kim-xps12/bsl-plotter/catkin_ws/src/bsl_plotter_description/meshes/base_link.stl

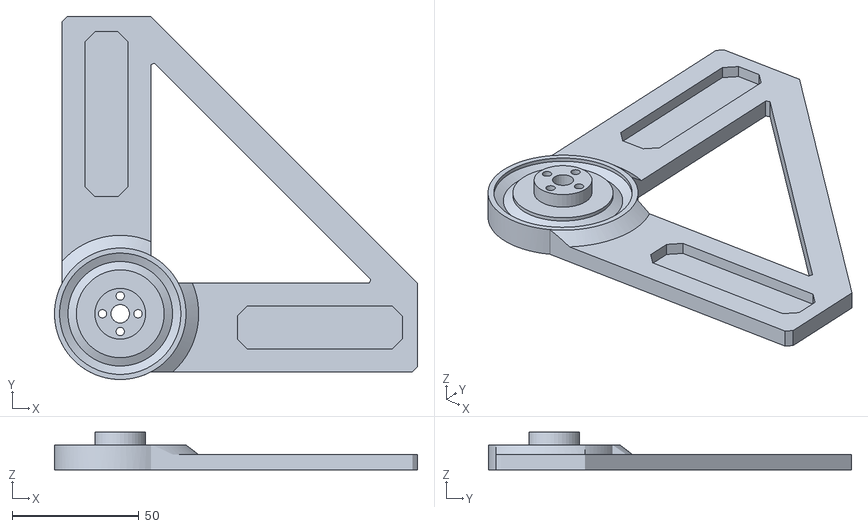
[picture p2: CAD file, 2023-05-23]
catkin_ws/src/bsl_plotter_description/meshes/base_link.stl
143.0 x 143.0 x 14.8
