kim-xps12/bsl-plotter/stl/rod_forearm v4.stl

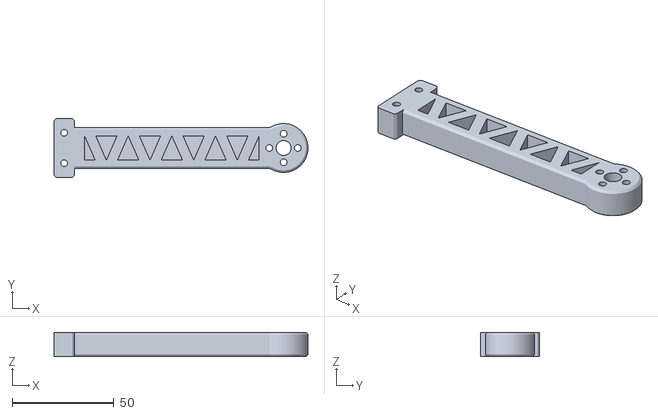
[picture p3: CAD file, 2023-05-24]
stl/rod_forearm v4.stl
124.8 x 29.0 x 12.0
