kim-xps12/bsl-plotter/catkin_ws/src/bsl_plotter_description/meshes/link_hand_v9_1.stl

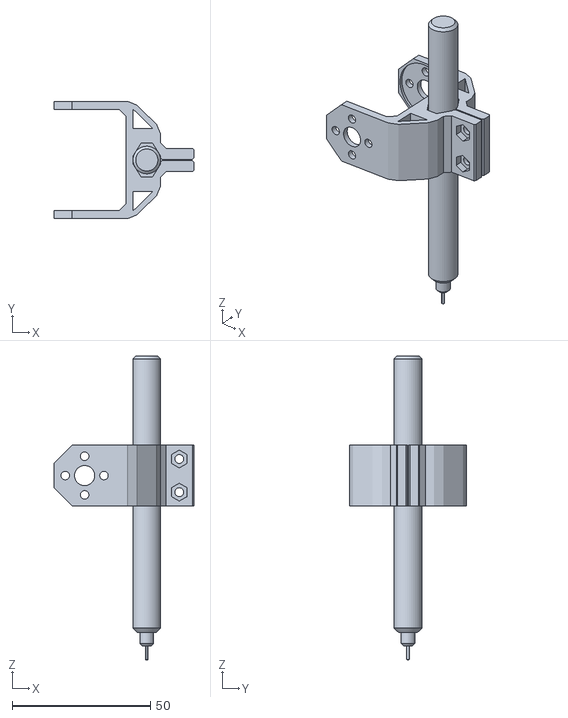
[picture p4: CAD file, 2023-05-23]
catkin_ws/src/bsl_plotter_description/meshes/link_hand_v9_1.stl
50.5 x 42.5 x 110.0
