kim-xps12/bsl-plotter/stl/mount_servo_arm_1 v24.stl

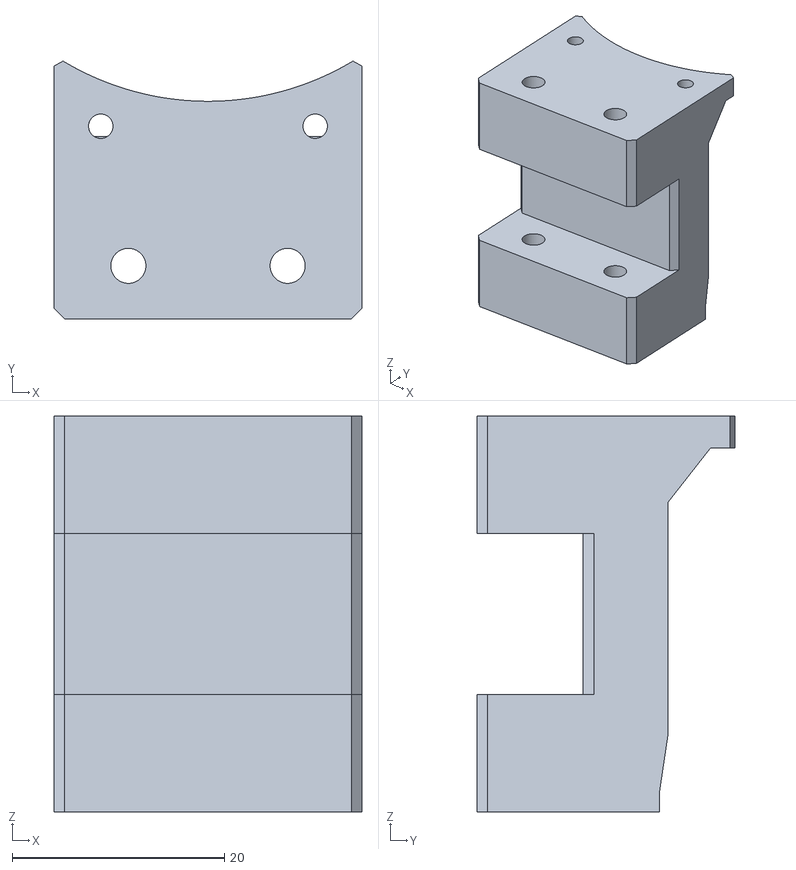
[picture p5: CAD file, 2023-05-24]
stl/mount_servo_arm_1 v24.stl
29.0 x 24.3 x 37.3
