kim-xps12/bsl-plotter/catkin_ws/src/bsl_plotter_description/meshes/link_upper_arm_v7_1.stl

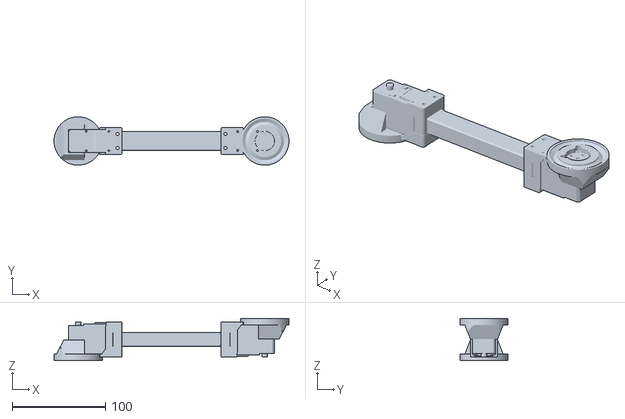
[picture p6: CAD file, 2023-05-23]
catkin_ws/src/bsl_plotter_description/meshes/link_upper_arm_v7_1.stl
251.8 x 51.8 x 45.2
