kim-xps12/bsl-plotter/catkin_ws/src/bsl_plotter_description/meshes/link_fore_arm_v4_1.stl

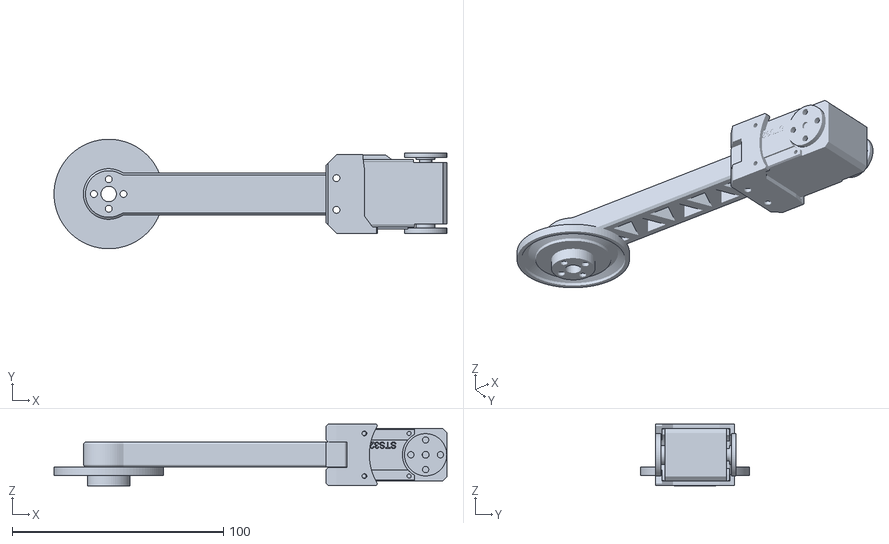
[picture p7: CAD file, 2023-05-23]
catkin_ws/src/bsl_plotter_description/meshes/link_fore_arm_v4_1.stl
186.0 x 51.8 x 29.2
