kim-xps12/bsl-plotter/stl/thrust_bearing_a v7.stl

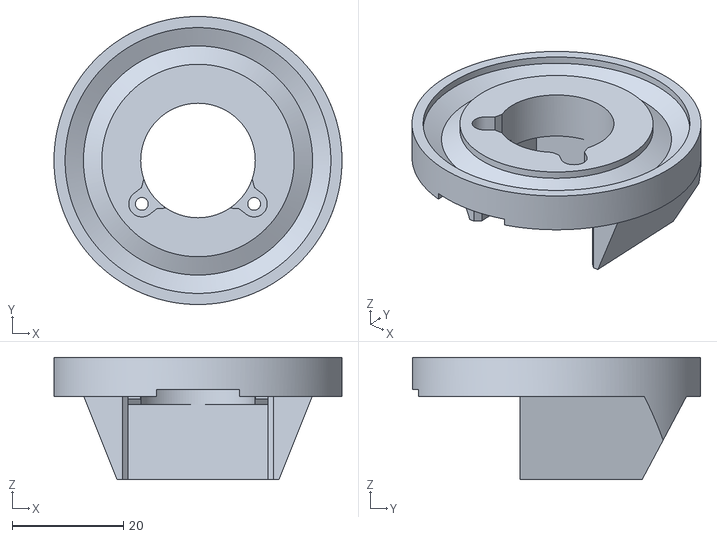
[picture p8: CAD file, 2023-05-24]
stl/thrust_bearing_a v7.stl
51.8 x 51.8 x 22.0
