kim-xps12/bsl-plotter/stl/link_hand v16.stl

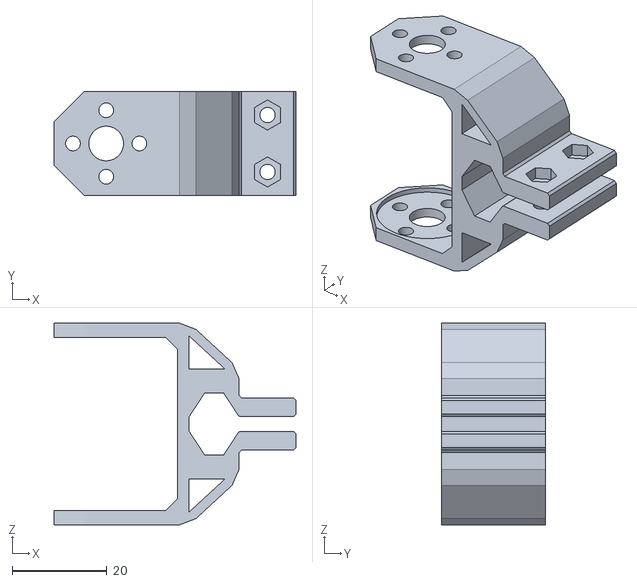
[picture p9: CAD file, 2023-05-24]
stl/link_hand v16.stl
51.0 x 22.0 x 42.5
