kim-xps12/bsl-plotter/stl/rod_upperarm v9.stl

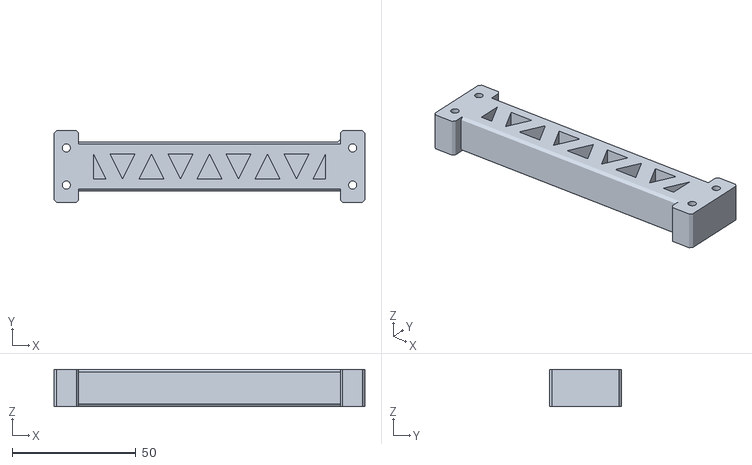
[picture p10: CAD file, 2023-05-24]
stl/rod_upperarm v9.stl
125.8 x 29.0 x 15.0
