kim-xps12/bsl-plotter/stl/thrust_bearing_b v2.stl

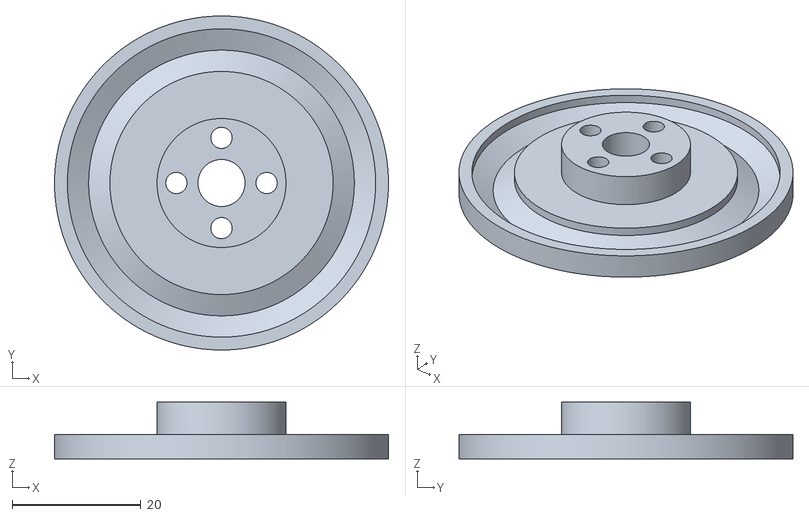
[picture p11: CAD file, 2023-05-24]
stl/thrust_bearing_b v2.stl
51.8 x 51.8 x 8.82
