kim-xps12/bsl-plotter/stl/spacer_arm v1.stl

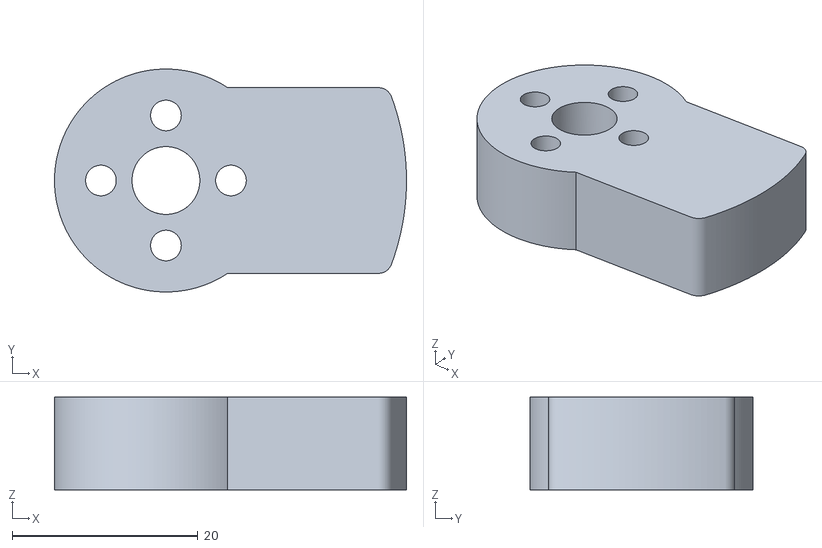
[picture p12: CAD file, 2023-05-24]
stl/spacer_arm v1.stl
37.9 x 24.0 x 10.0
