kim-xps12/bsl-plotter/(list of files, cad)

Other CAD files:
stl/mount_servo_hand v10.stl
stl/base_link v14.stl
stl/mount_servo_arm_2 v6.stl
