kim-xps12/bsl-plotter/catkin_ws/src/bsl_plotter_description/launch/controller.yaml

bsl_plotter_controller:
  # Publish all joint states -----------------------------------
  joint_state_controller:
    type: joint_state_controller/JointStateController
    publish_rate: 50

  # Position Controllers --------------------------------------
  rev1_position_controller:
    type: effort_controllers/JointPositionController
    joint: rev1
    pid: {p: 100.0, i: 0.01, d: 10.0}
  rev2_position_controller:
    type: effort_controllers/JointPositionController
    joint: rev2
    pid: {p: 100.0, i: 0.01, d: 10.0}
  rev3_position_controller:
    type: effort_controllers/JointPositionController
    joint: rev3
    pid: {p: 100.0, i: 0.01, d: 10.0}
