kim-xps12/bsl-plotter/(commit log)

2023-03-24 disable joint_state_publisher
2023-05-18 Add config file and usage of terminator (#2)
    * Add config file and usage of terminator
    * Fix terminator config
    * Fix README
    * Modify README (Add `docker-compose up -d`)
    * Fix README (Change attach command)
    * Add documentation on how to use terminators
    * Add how to use terminator in README.md
2023-05-22 release (#5)
    * Add config file and usage of terminator (#2)
    * Add pip packages and bashrc settings (#4)
    ---------
    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
2023-05-23 Feature/implement ik (#6)
    * implement inverse-kinematics with ChatGPT
    * update urdf model
    * implemet IK, controller class, lesson1-3
    * fix topic name, and lesson beta test
    [base_link.stl, bsl_plotter.xacro, bsl_plotter2.xacro, controller.yaml, link_fore_arm_v3_1.stl, link_fore_arm_v4_1.stl, link_hand_v4_1.stl, link_hand_v9_1.stl]
2023-05-23 release (#5) (#7)
    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
2023-05-23 release (#8)
    * Feature/implement ik (#6)
    * release (#5) (#7)
    * Fix terminat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
    [base_link.stl, bsl_plotter.xacro, bsl_plotter2.xacro, controller.yaml, link_fore_arm_v3_1.stl, link_fore_arm_v4_1.stl, link_hand_v4_1.stl, link_hand_v9_1.stl]
2023-05-24 Feature/add parts stl (#9)
    * add parts stl model
    * Update README.md for assembly
    [base_link v14.stl, link_hand v16.stl, mount_servo_arm_1 v24.stl, mount_servo_arm_2 v6.stl, mount_servo_hand v10.stl, rod_forearm v4.stl, rod_upperarm v9.stl, spacer_arm v1.stl]
2023-05-25 Release (#11)
    * Delete answers from lesson.py (#10)
    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
    [base_link v14.stl, link_hand v16.stl, mount_servo_arm_1 v24.stl, mount_servo_arm_2 v6.stl, mount_servo_hand v10.stl, rod_forearm v4.stl, rod_upperarm v9.stl, spacer_arm v1.stl]
2023-05-25 add finger TF (#14)
    [bsl_plotter.xacro]
2023-08-08 Add/test and visualizer (#19)
    * add test script
    * add jsk visualizer
    * fix node name
    * update README
    [test_swing.py]
2023-08-08 Fix/ik model (#20)
    * fix wrong IK model
    * add overview image
    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
    [arm_control.py]
2023-10-16 Update README.md, BOM and Servo ID setting
2024-02-22 Update README (bolts and cable extension)
2024-02-22 Update README (cable length in BOM)
2024-02-28 Feature/update class names (#21)
    * fix launch name
    * change class name arm_control -> control_arm
    * fix lesson node name
    [control_arm.py, lesson.py]
2024-03-11 update assembled plotter image in the README
2025-05-30 Noetic arm feature/move pen (#22)
    * add lift_pen(), and lower_pen()
    * Update catkin_ws/src/plotter_controller/src/lesson.py
    LGTM
    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
